ai03-2725/Tenkey-Numpads/README.md

# Tenkey-Numpads

天キー（[天下一キーボードわいわい会](https://tenkey.connpass.com)）用に設計したテンキー用ケースデータです。
