ai03-2725/Tenkey-Numpads/Tenkey-Basic-Numpad/README.md

# Tenkey-Basic-Numpad

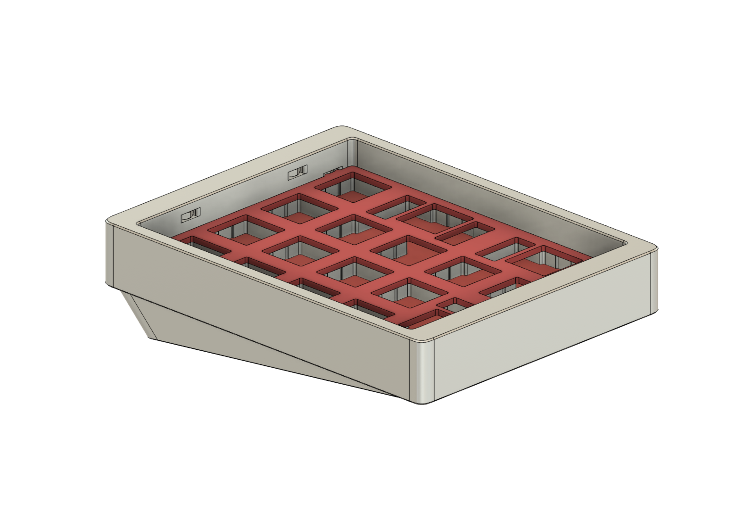
[picture p1: Tenkey-Basic-Numpad/Images/tenkey-basic-numpad.png]
Cover


3Dプリントでの製造を想定したシンプルなテンキーケースです。

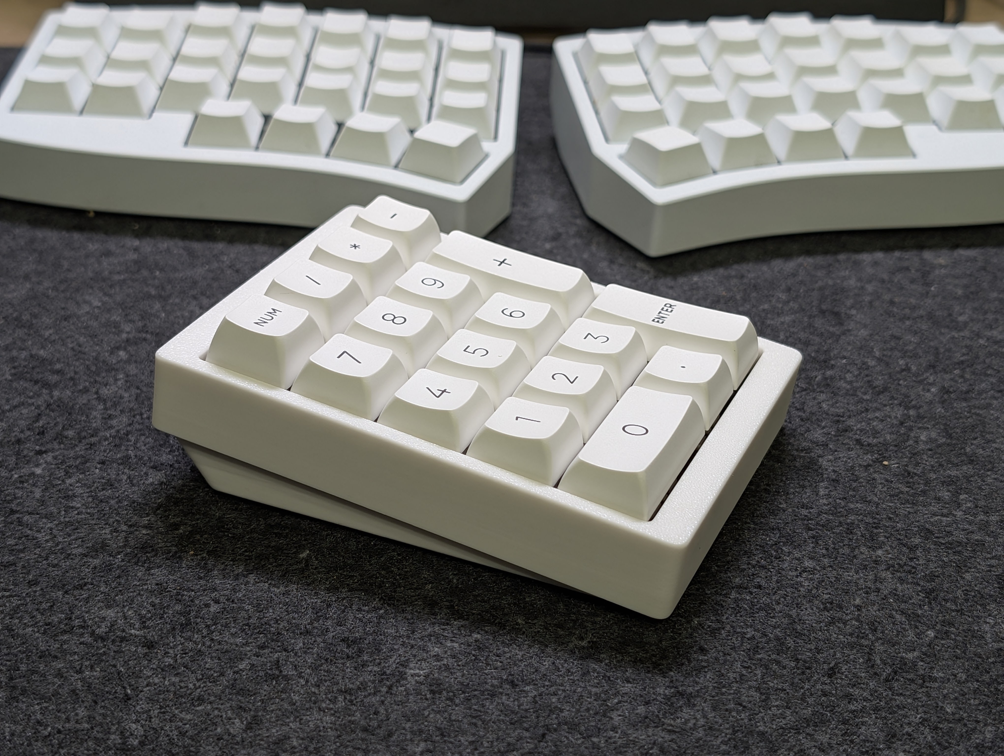
[picture p2: Tenkey-Basic-Numpad/Images/tenkey-basic-numpad-build-1.jpg]
Build

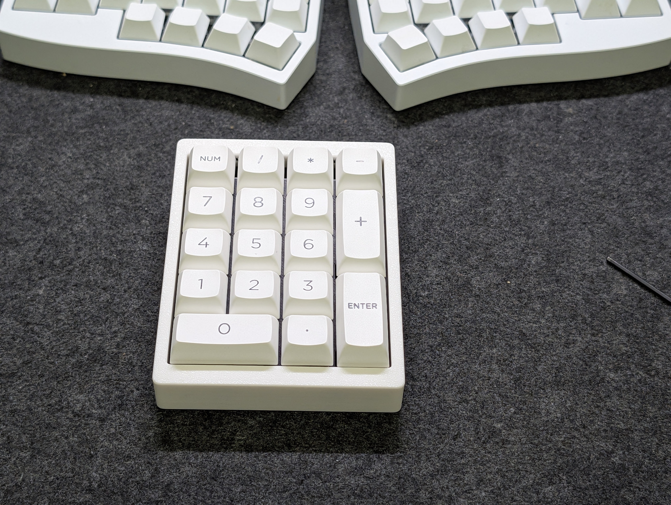
[picture p3: Tenkey-Basic-Numpad/Images/tenkey-basic-numpad-build-2.jpg]
Build


## プリントリスト

`STLs/`
- `Top.stl` - ケース上側
- `Bottom Unsupported.stl` - ケース下側
  - USBポート周りにサポートパーツが付属する`Bottom Built-In Support 0.1/0.2mm Gap.stl`もあります。印刷に利用するレイヤー厚に合ったファイルをご利用ください。
- `Plate.stl` - プレート
- `Diffuser.stl` - ミッドフォーム的な中間レイヤー
  - TPUなどで壁ループ0、上下レイヤー0などで印刷することで、フォーム層に似た効果のパーツを作製できます。

## パーツリスト
- 8 x M2.5 6角ナット
- 8 x M2.5x8mmネジ
- 4x 8mm径ゴム足

ナットをケース上側のスロットに差し込んでください。
