ai03-2725/Tenkey-Numpads/Vol12-Session/README.md

# Vol12-Session-Numpad

天キーVol.12のセッション用に設計したテンキーケースです。

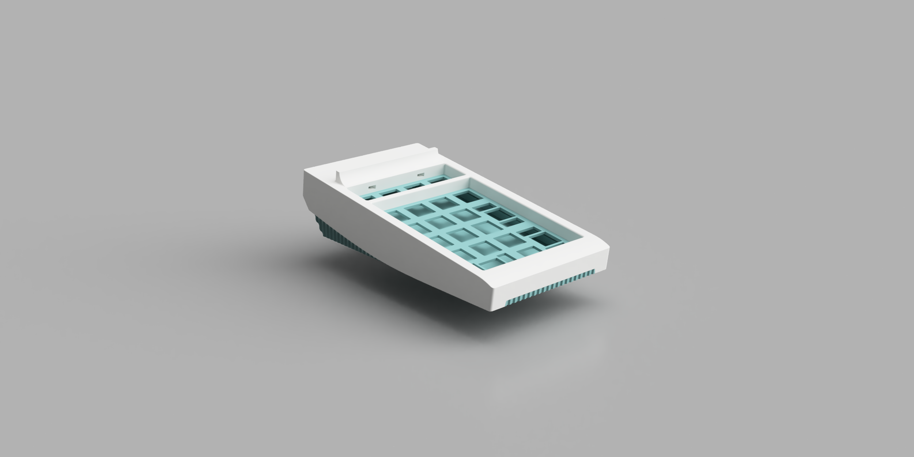
[picture p4: Vol12-Session/Images/render-default.PNG]
Render Default

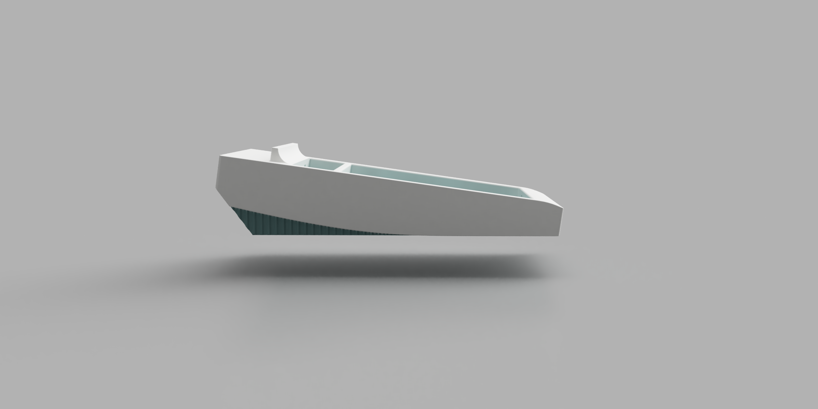
[picture p5: Vol12-Session/Images/render-side.PNG]
Render Default

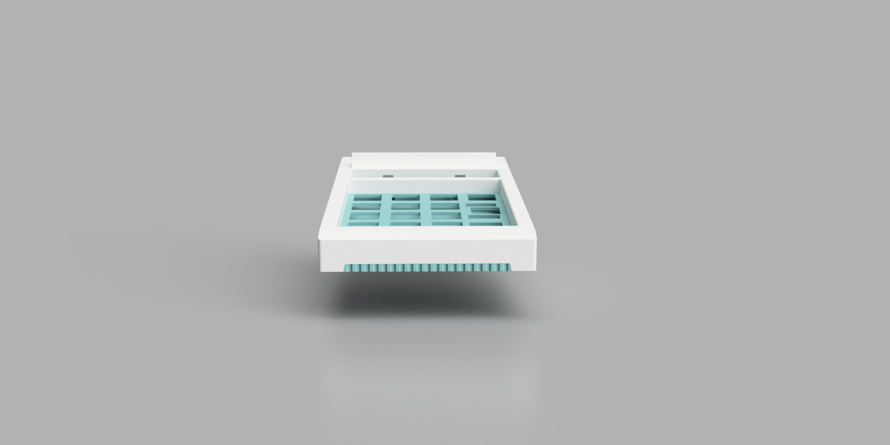
[picture p6: Vol12-Session/Images/render-front.PNG]
Render Default


## プリントリスト
- `Top Unsupported.stl` - ケース上側
  - 下にする面は後ろの斜めの部分です。
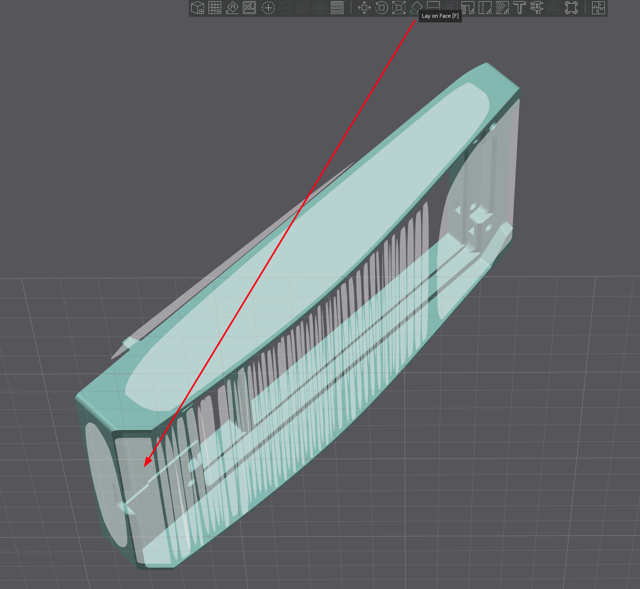
[picture p7: Vol12-Session/Images/bottom-face.png]
Bottom face
    
  - サポートを以下の面に追加してください。
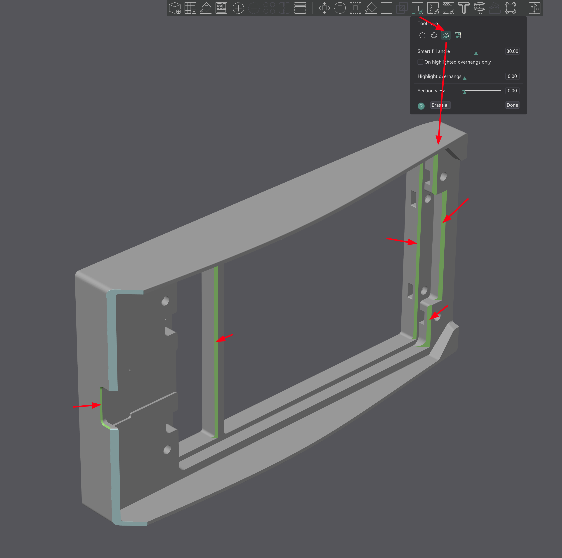
[picture p8: Vol12-Session/Images/support-locs.png]
Support locations
    
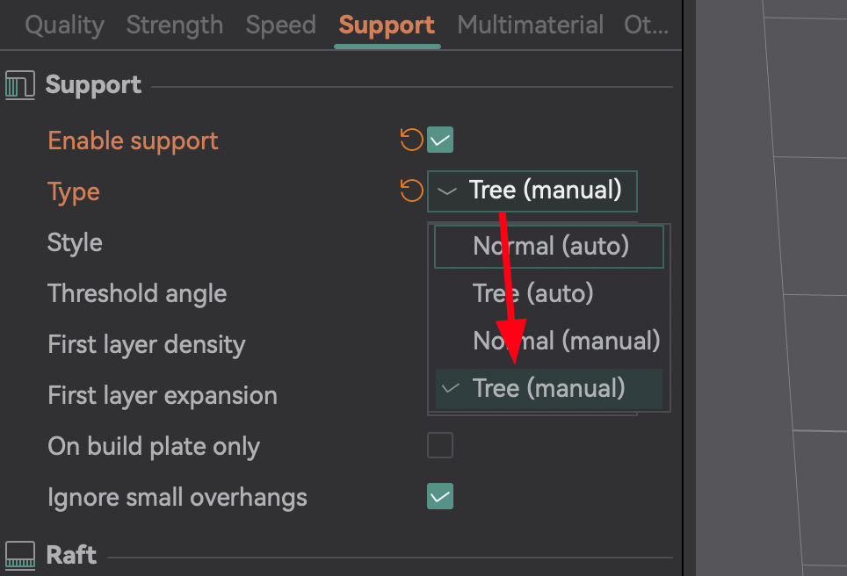
[picture p9: Vol12-Session/Images/support-enable.png]
Support settings
    
  - 正しく設定した場合、スライス後はこのような見た目になります。
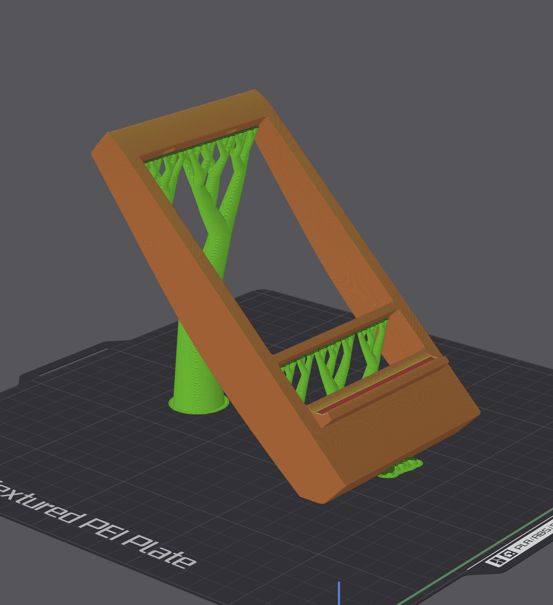
[picture p10: Vol12-Session/Images/top-sliced-front.png]
Top sliced - Front
    
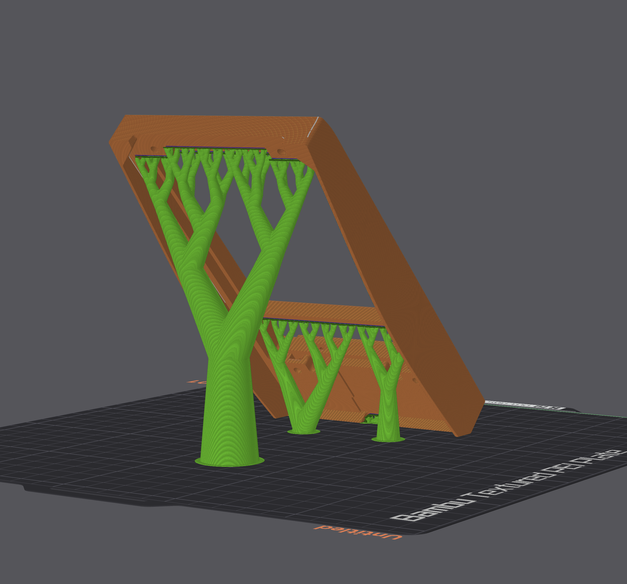
[picture p11: Vol12-Session/Images/top-sliced-rear.png]
Top sliced - Rear
    
  - 横面の壁が印刷中に歪む場合、ケースを補助ファンの送風方向へ向けたり、歪み防止構造が追加された`Top Supported.stl`を利用したりしてください。
  - ビルドプレートへの定着が不足している場合、ブリムなどを有効化してください。
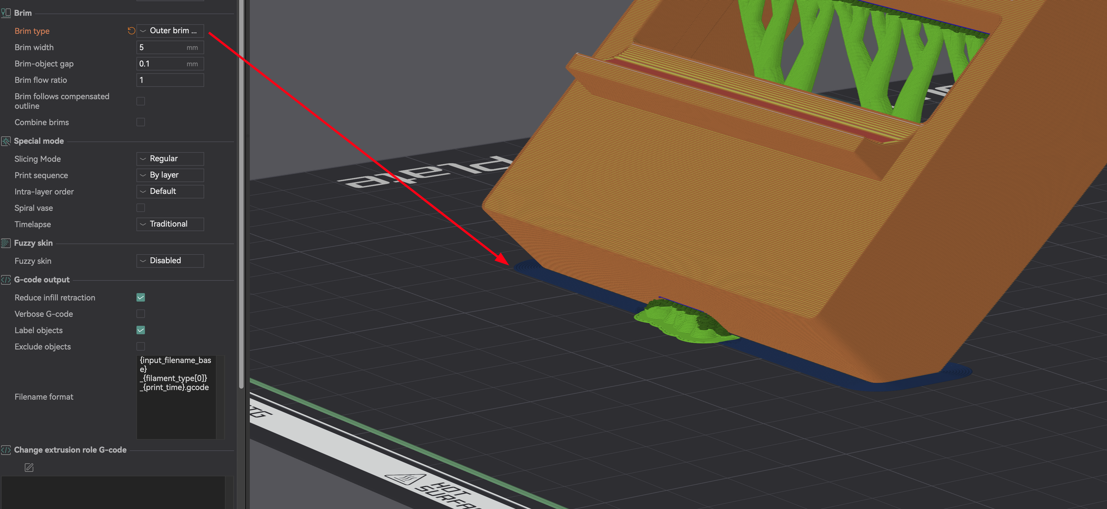
[picture p12: Vol12-Session/Images/brim.png]
Brim settings
    
- `Bottom.stl` - ケース下側
  - ケース上側と同様に、後ろの斜めの面が下になるように印刷してください。
    必要に応じてUSBポート周りにサポートを追加してください。
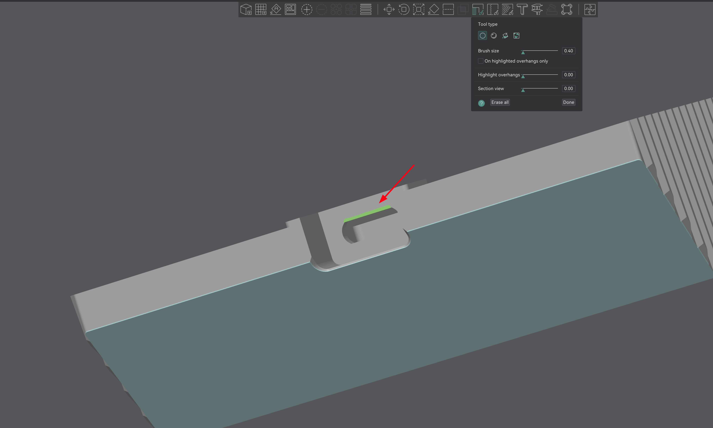
[picture p13: Vol12-Session/Images/bottom-usb-supports.png]
Bottom supports
    
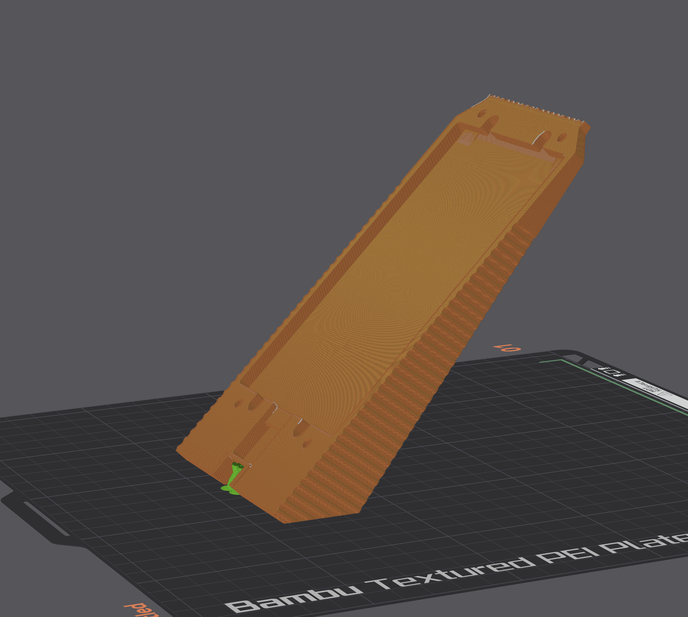
[picture p14: Vol12-Session/Images/bottom-sliced.png]
Bottom sliced
    
- `Plate.stl` - プレート

## パーツリスト
- 8 x DIN 562 M3四角ナット
- 8 x M3x8mmネジ
- 4x 8mm径ゴム足

## PCBについて
セッションの内容用にケース側を優先したため、PCBデータは存在しません。  
`Source/`フォルダー内にあるSTEPファイルにPCBの形状データが内蔵されています。  

## 組み立て手順
1. パーツを印刷します。
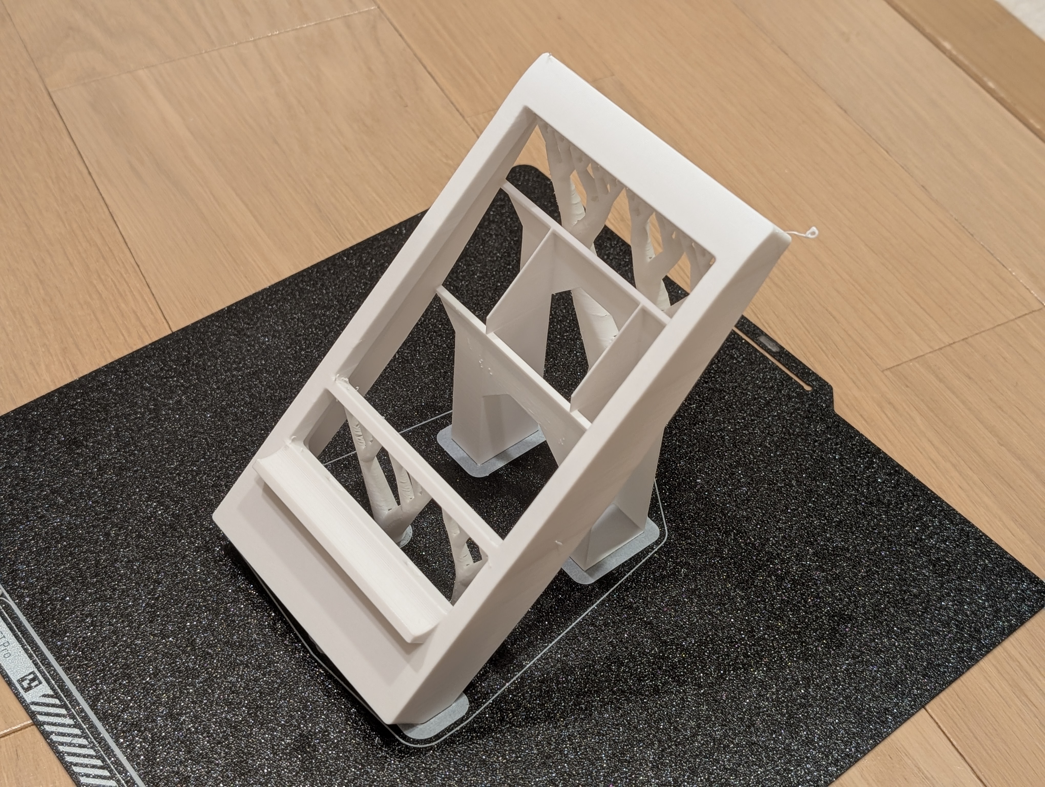
[picture p15: Vol12-Session/Images/print-top-supported.jpg]
Print top unsupported
  
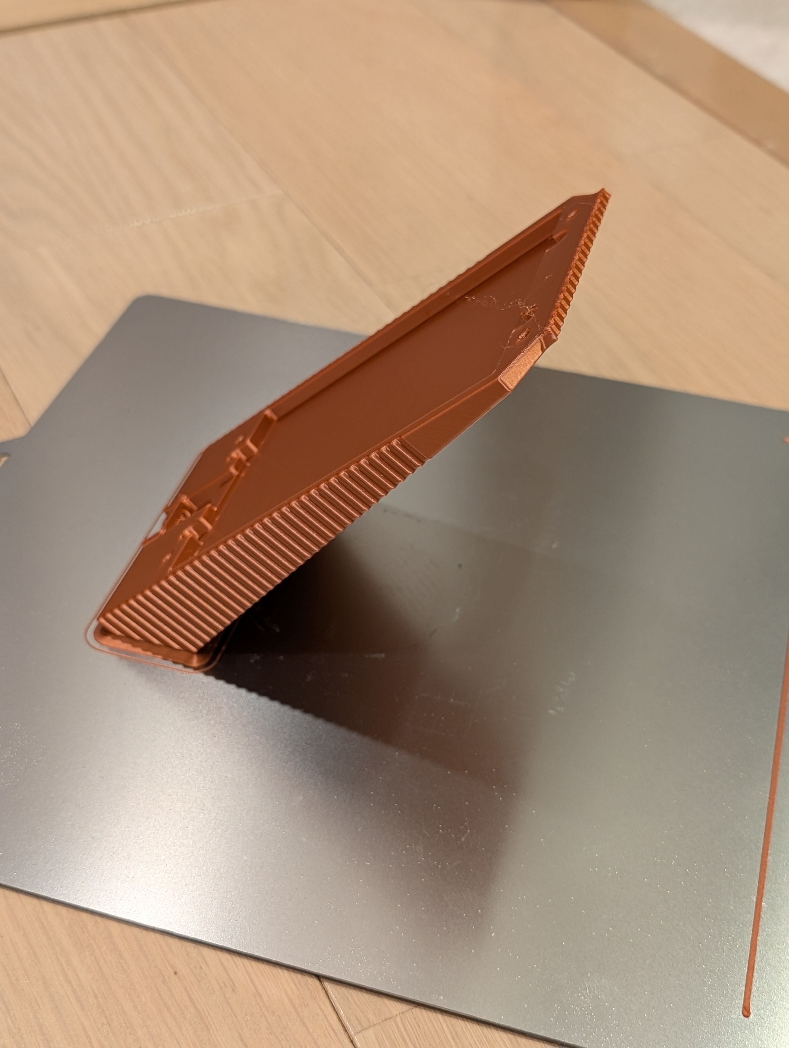
[picture p16: Vol12-Session/Images/print-bottom.jpg]
Print bottom
  
1. DIN 562ナットをケース上側のスロットに入れます。
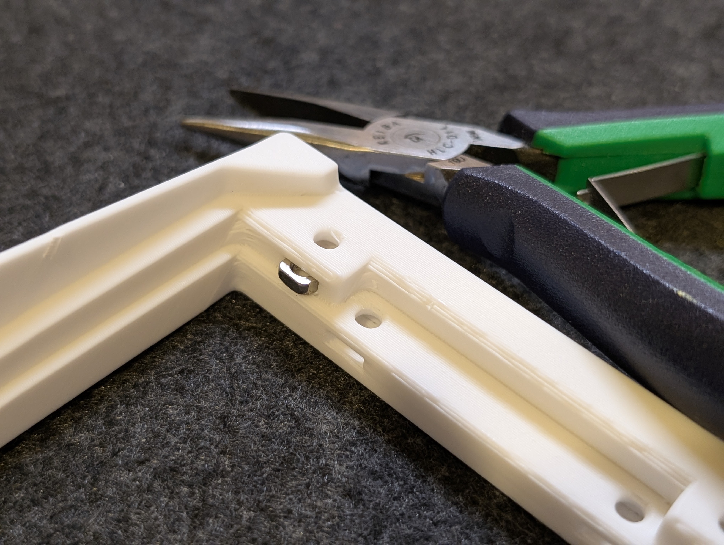
[picture p17: Vol12-Session/Images/nut-inserting.jpg]
Nut installation
  
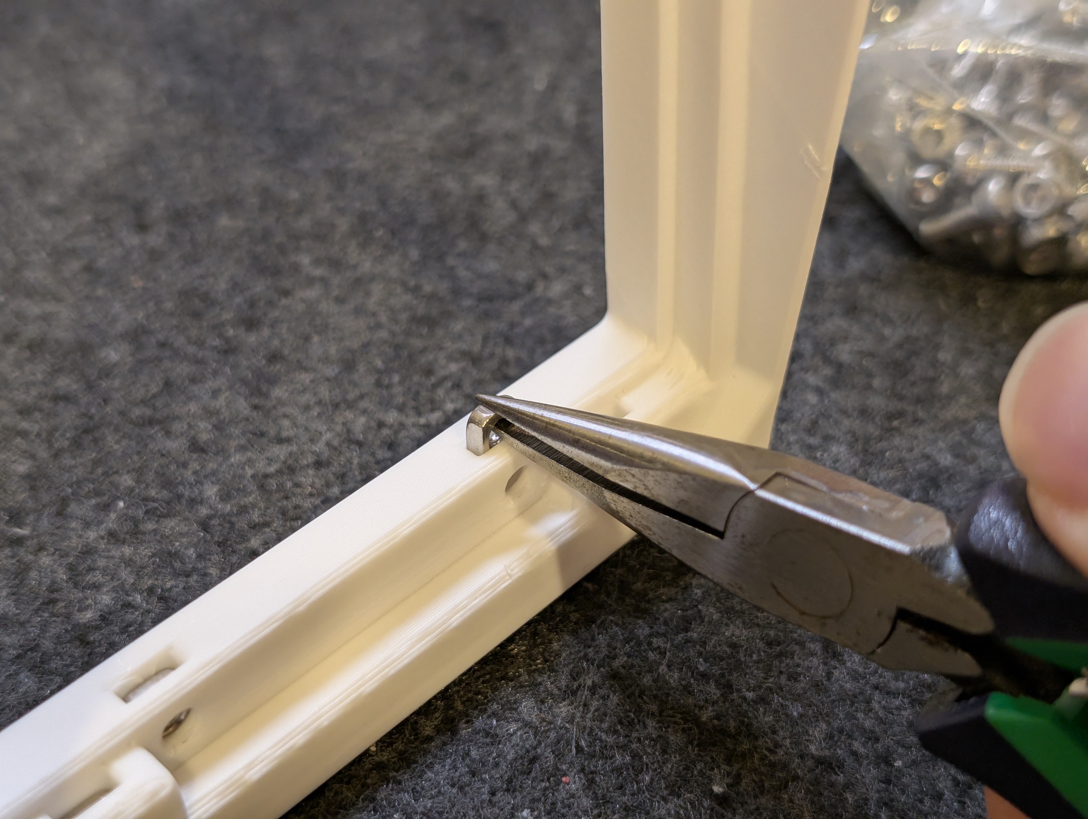
[picture p18: Vol12-Session/Images/nut-pliers.jpg]
Plier usage
  
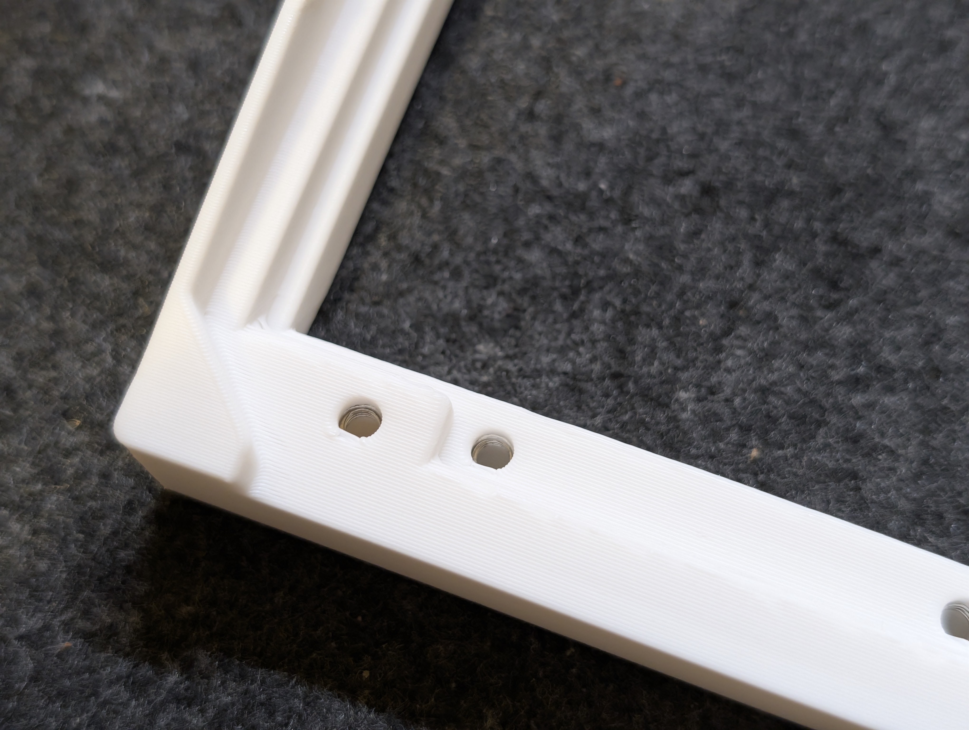
[picture p19: Vol12-Session/Images/nut-inserted.jpg]
Nuts installed
  
1. PCBにスタビライザーを搭載し、プレートにスイッチを入れて内部部分を組み立てます。
1. 内部部分（プレート＋スイッチ＋PCB）をケース上側にネジで固定します。
1. ケース上下を組み合わせ、ネジ止めします。
