ai03-2725/Tenkey-Numpads/Vol12-Session/Images/skirt.png

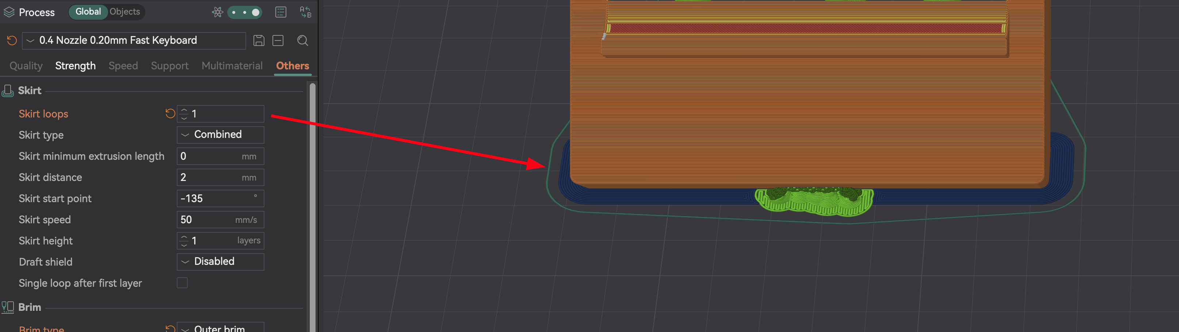
Vol12-Session/Images/skirt.png
