ai03-2725/Tenkey-Numpads/Tenkey-Basic-Numpad/Source/Tenkey-Basic-Numpad-Source.step

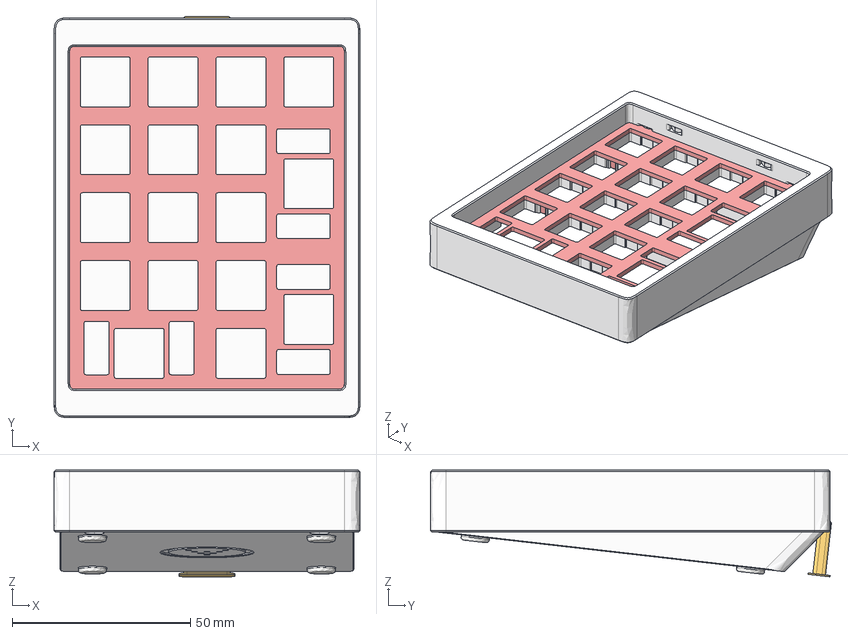
[picture p21: CAD file, 2026-10-23]
Tenkey-Basic-Numpad/Source/Tenkey-Basic-Numpad-Source.step
85.9 x 112.6 x 30.0 mm
HRO TYPE-C-31-M-12 Revised
Hex Socket DIN912 M2.5 x 8
Rubber Feet x 4
Bottom
Plate
Top
Diffuser
