ai03-2725/Tenkey-Numpads/Tenkey-Basic-Numpad/STLs/Plate.stl

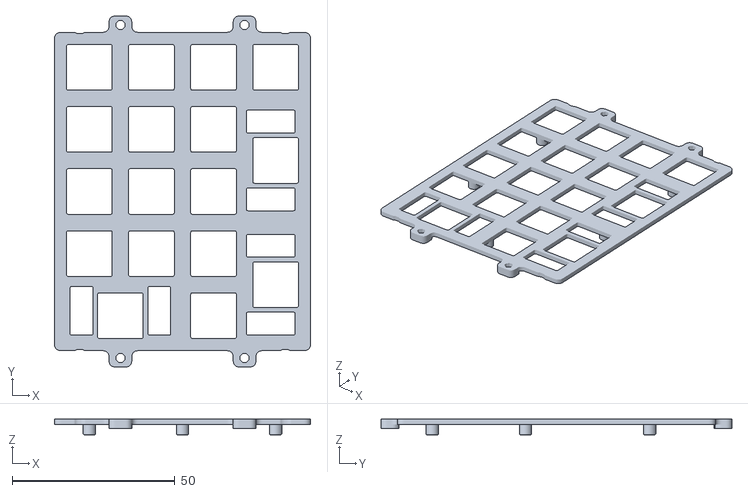
[picture p22: CAD file, 2026-10-23]
Tenkey-Basic-Numpad/STLs/Plate.stl
78.7 x 107.7 x 4.80
