ai03-2725/Tenkey-Numpads/Vol12-Session/Source/Tenkey-Session-Numpad Source.step

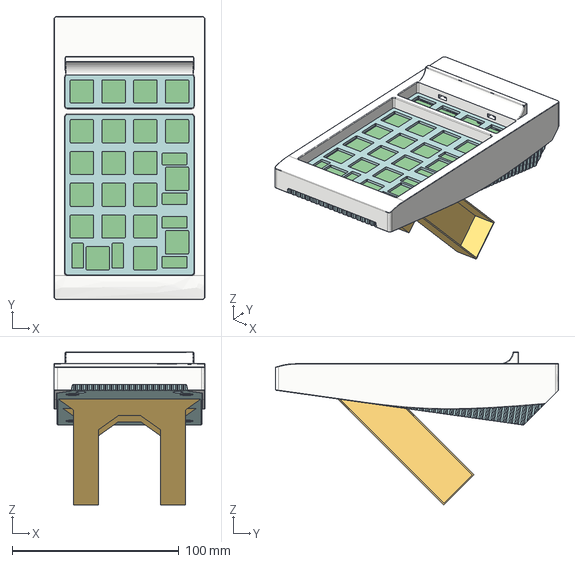
[picture p23: CAD file, 2026-10-23]
Vol12-Session/Source/Tenkey-Session-Numpad Source.step
90.7 x 170.0 x 91.8 mm
