ai03-2725/Tenkey-Numpads/Vol12-Session/STLs/Plate.stl

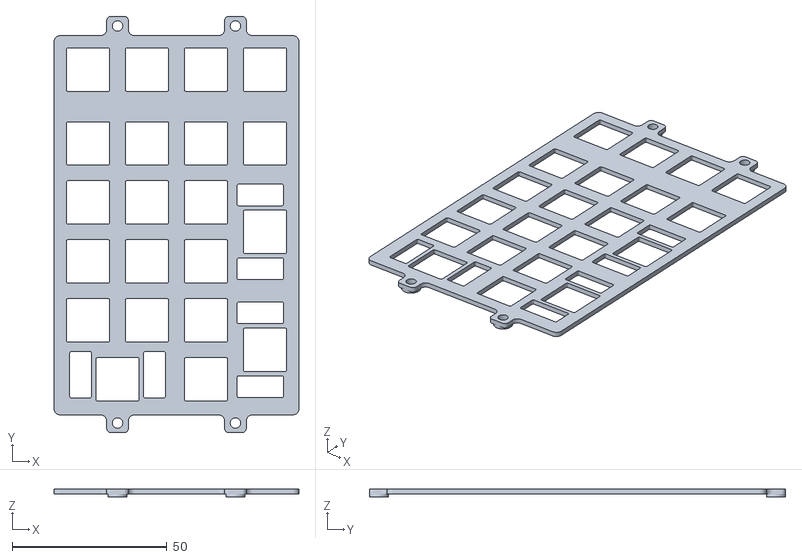
[picture p24: CAD file, 2026-10-23]
Vol12-Session/STLs/Plate.stl
79.2 x 134.5 x 2.60
