ai03-2725/Tenkey-Numpads/Tenkey-Basic-Numpad/STLs/Bottom Built-In Support 0.1mm Gap.stl

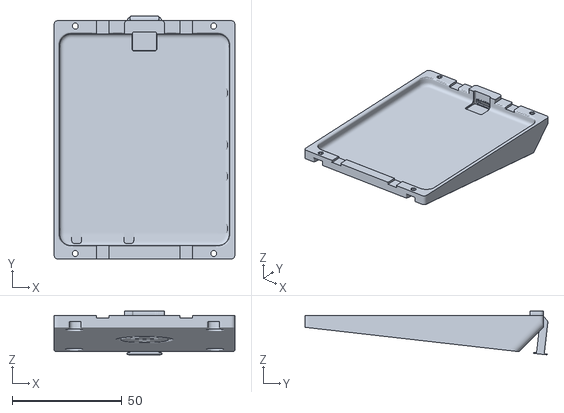
[picture p25: CAD file, 2026-10-23]
Tenkey-Basic-Numpad/STLs/Bottom Built-In Support 0.1mm Gap.stl
82.5 x 110.9 x 20.0
