ai03-2725/Tenkey-Numpads/Vol12-Session/STLs/Bottom.stl

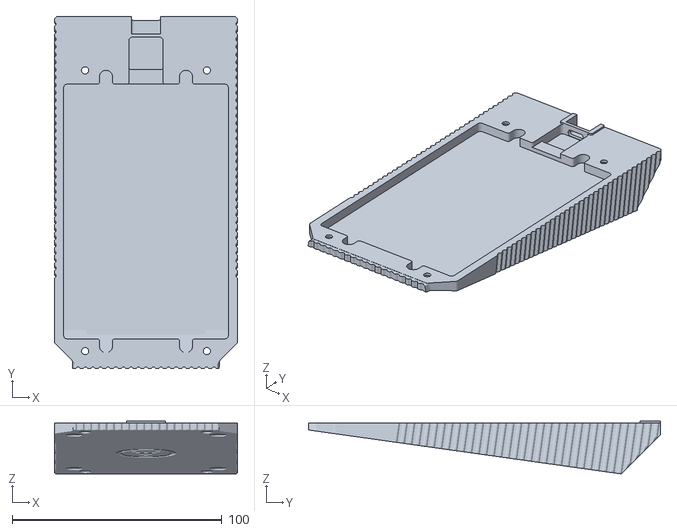
[picture p26: CAD file, 2026-10-23]
Vol12-Session/STLs/Bottom.stl
87.2 x 167.9 x 25.2
