ai03-2725/Tenkey-Numpads/Vol12-Session/STLs/Top Unsupported.stl

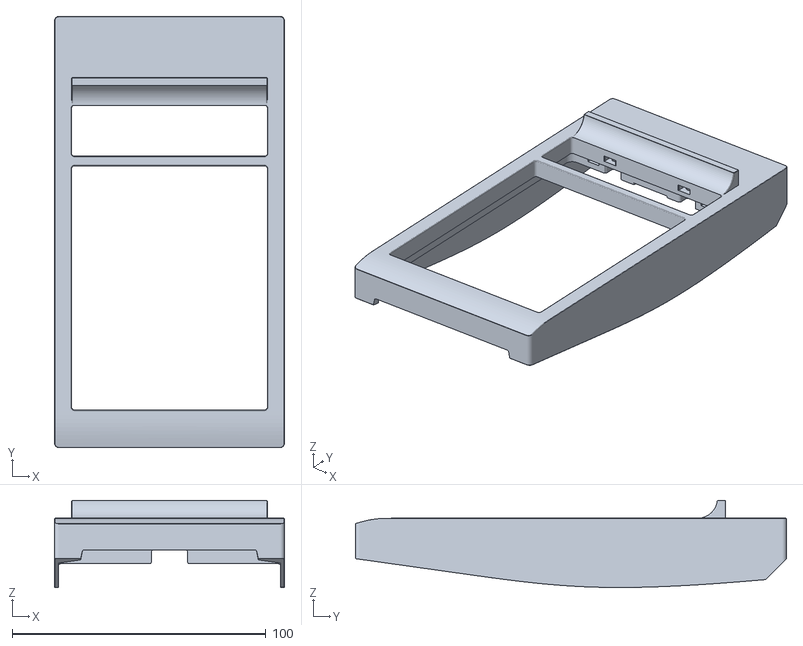
[picture p27: CAD file, 2026-10-23]
Vol12-Session/STLs/Top Unsupported.stl
90.7 x 170.0 x 34.3
