ai03-2725/Tenkey-Numpads/Tenkey-Basic-Numpad/STLs/Bottom Unsupported.stl

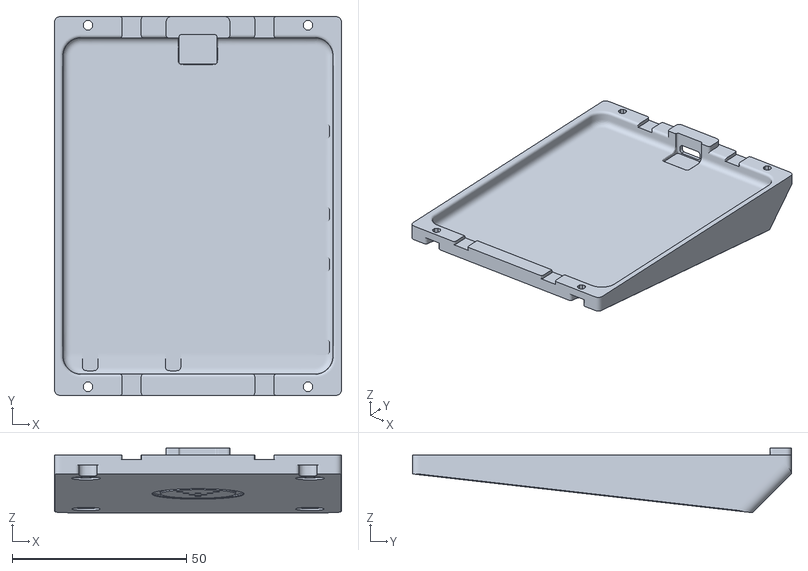
[picture p28: CAD file, 2026-10-23]
Tenkey-Basic-Numpad/STLs/Bottom Unsupported.stl
82.5 x 108.8 x 18.5
