ai03-2725/Tenkey-Numpads/Vol12-Session/STLs/Top Supported.stl

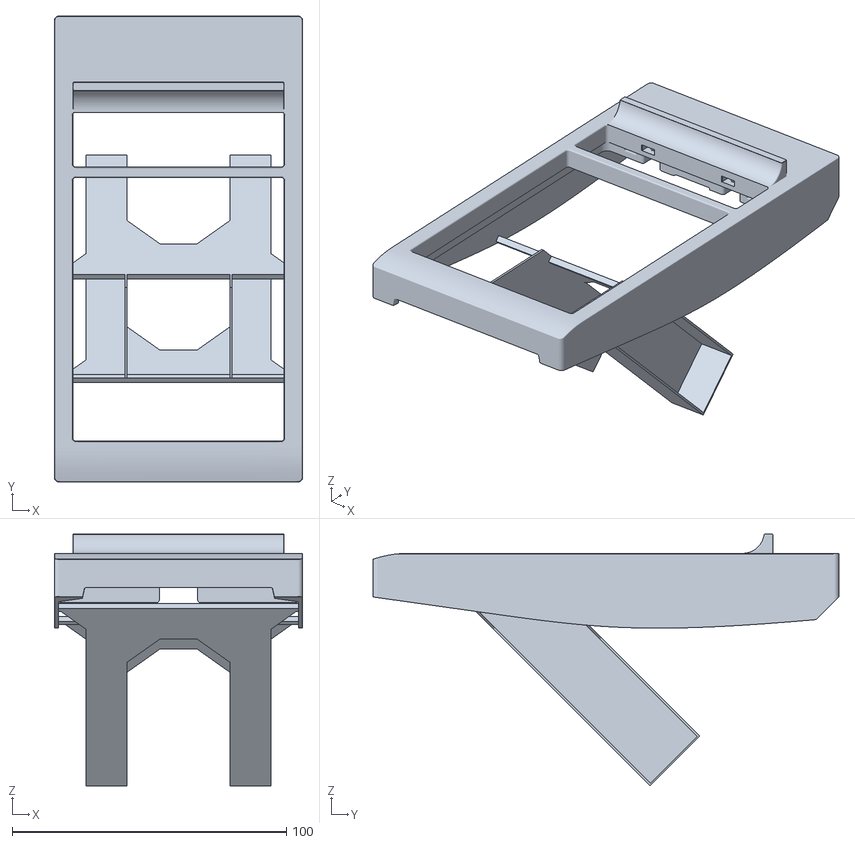
[picture p29: CAD file, 2026-10-23]
Vol12-Session/STLs/Top Supported.stl
90.7 x 170.0 x 91.8
