ai03-2725/Tenkey-Numpads/Tenkey-Basic-Numpad/STLs/Diffuser.stl

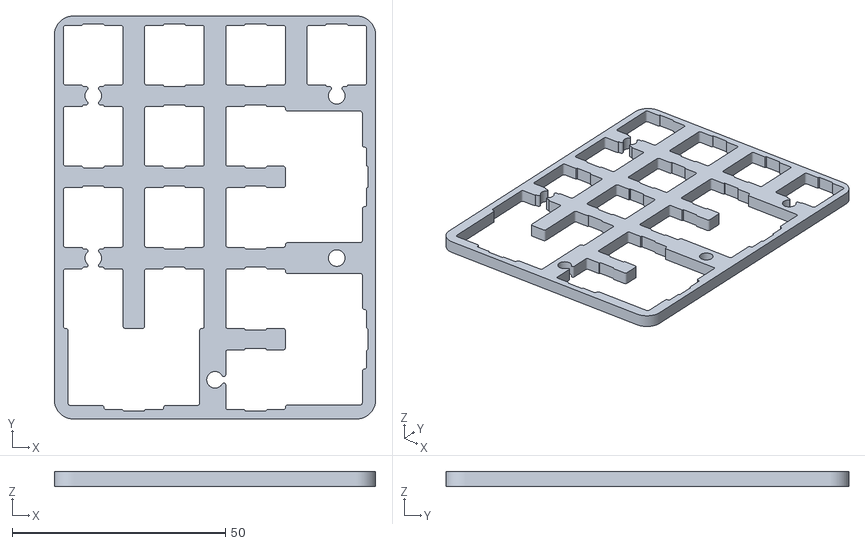
[picture p30: CAD file, 2026-10-23]
Tenkey-Basic-Numpad/STLs/Diffuser.stl
75.4 x 94.6 x 3.50
