ai03-2725/Tenkey-Numpads/Tenkey-Basic-Numpad/STLs/Top.stl

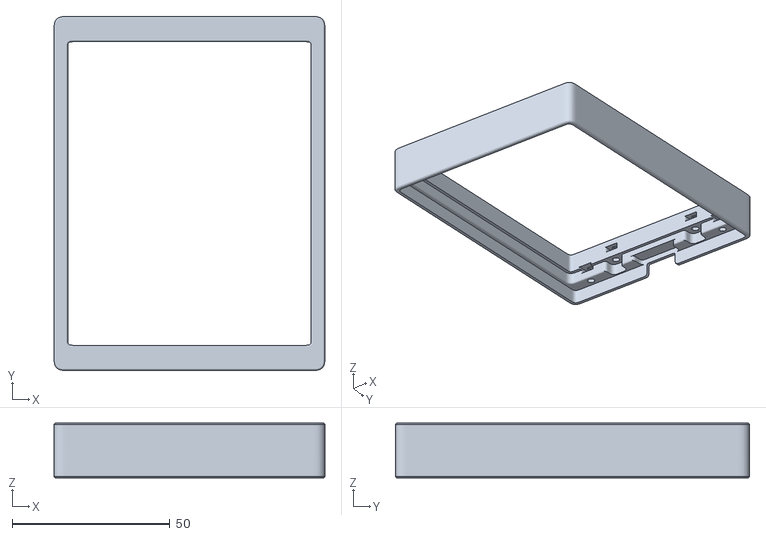
[picture p31: CAD file, 2026-10-23]
Tenkey-Basic-Numpad/STLs/Top.stl
85.9 x 112.2 x 17.4
