ai03-2725/Tenkey-Numpads/(list of files, cad)

Other CAD files:
Tenkey-Basic-Numpad/STLs/Bottom Built-In Support 0.2mm Gap.stl
