ai03-2725/Tenkey-Numpads/Vol12-Session/Images/build-1.jpg

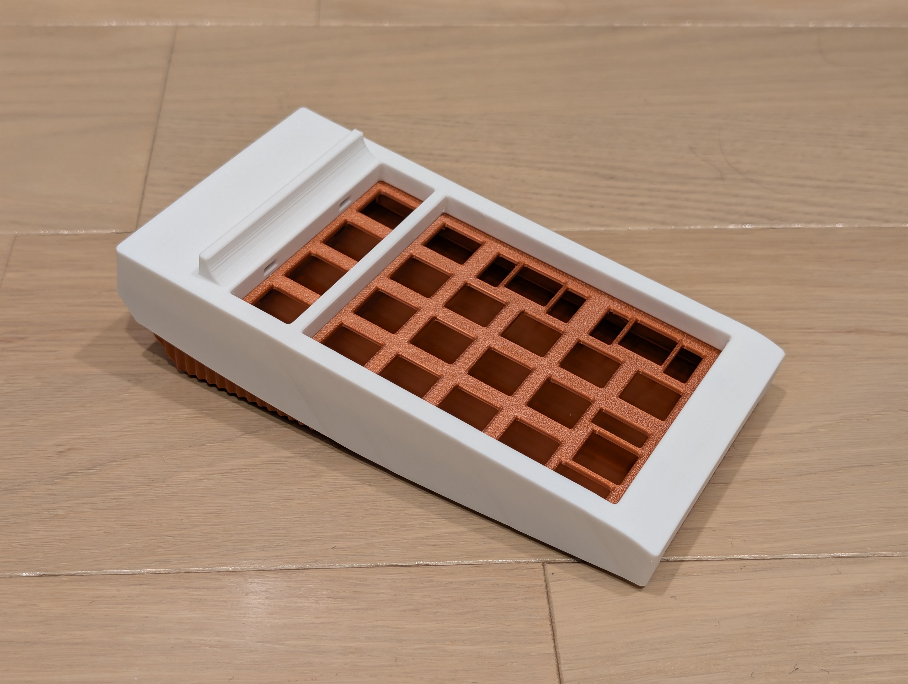
Vol12-Session/Images/build-1.jpg
