ai03-2725/Tenkey-Numpads/Vol12-Session/Images/print-top-unsupported.jpg

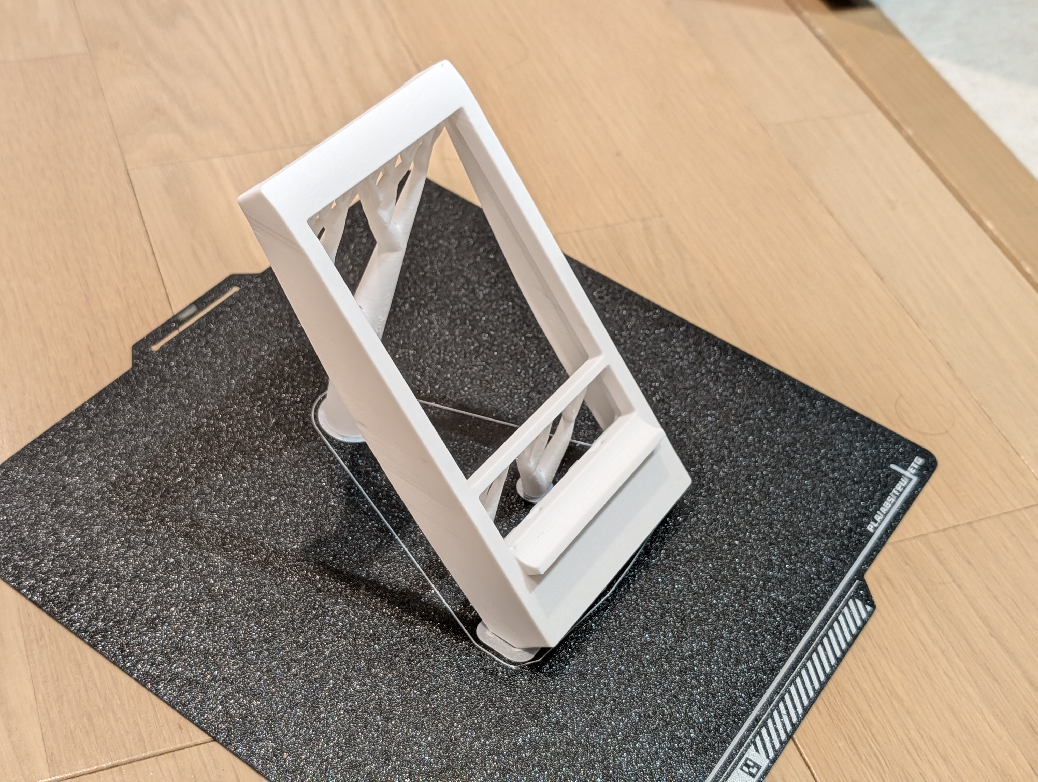
Vol12-Session/Images/print-top-unsupported.jpg
